cjaycalhoun/retro-clock-assistant/esphome/respeaker-voice-assistant.NOT_INCLUDED.md

# ReSpeaker Voice Assistant YAML Not Included

The full ReSpeaker ESPHome YAML is intentionally not included in this initial scaffold because it may contain device-specific settings or sensitive configuration.
