cjaycalhoun/retro-clock-assistant/stl/hisonic-led-socket.stl

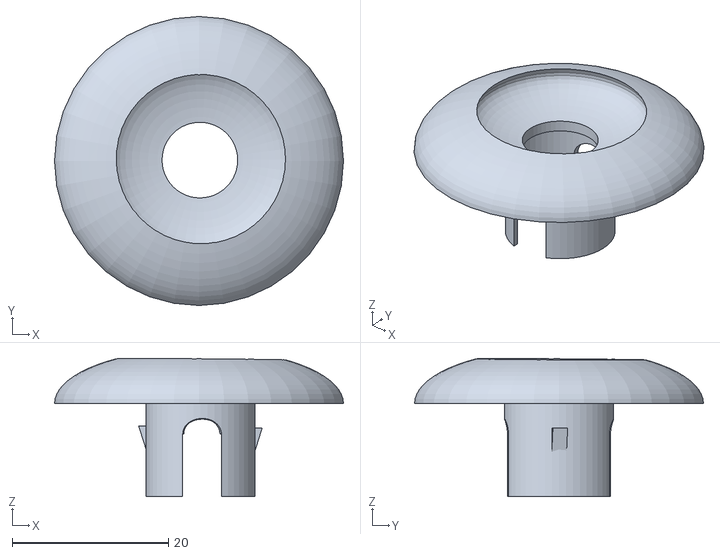
[picture p1: CAD file, 2026-10-13]
stl/hisonic-led-socket.stl
37.0 x 37.0 x 17.7
