cjaycalhoun/retro-clock-assistant/stl/hisonic-motor-ticker.stl

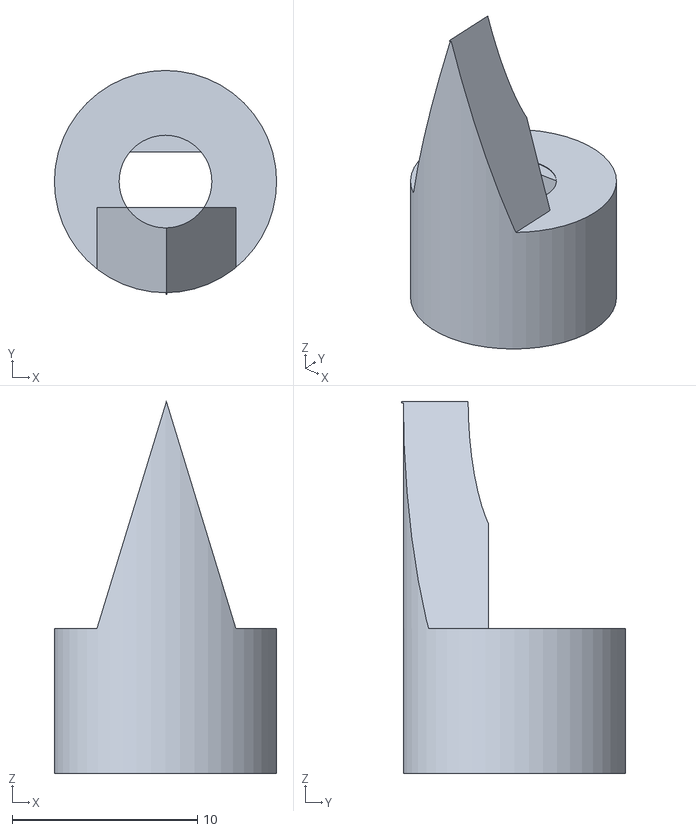
[picture p2: CAD file, 2026-10-13]
stl/hisonic-motor-ticker.stl
12.0 x 12.1 x 20.1
