cjaycalhoun/retro-clock-assistant/stl/hisonic-inner-brace.stl

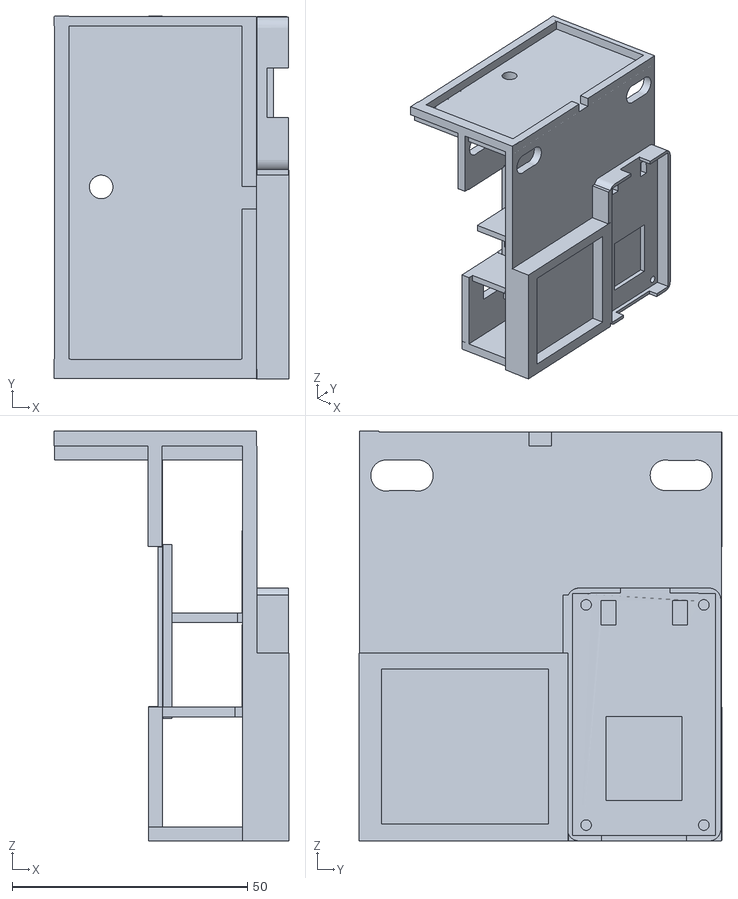
[picture p3: CAD file, 2026-10-13]
stl/hisonic-inner-brace.stl
49.9 x 77.2 x 87.2
