cjaycalhoun/retro-clock-assistant/assets/diagrams/hisonic-wiring-diagram-v2.png

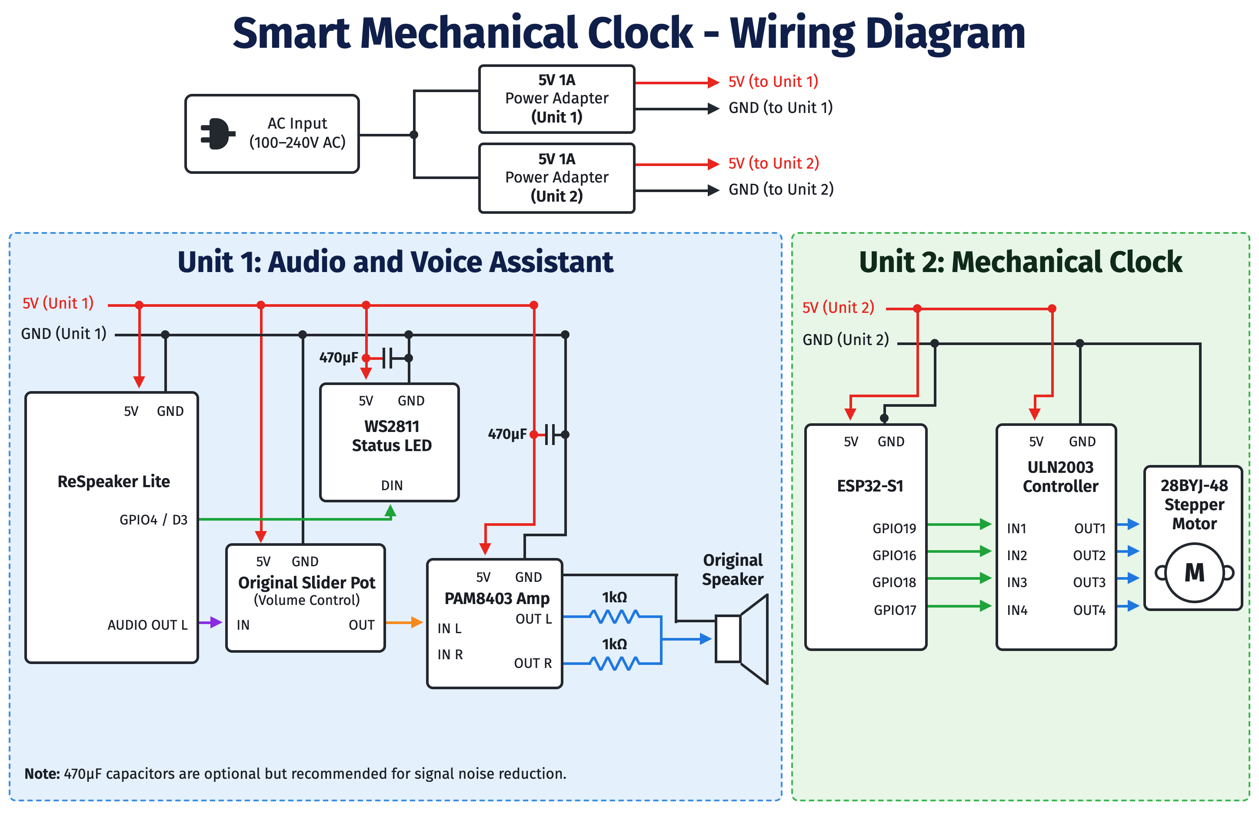
assets/diagrams/hisonic-wiring-diagram-v2.png
