cjaycalhoun/retro-clock-assistant/CHANGELOG.md

# Changelog

## Unreleased

- Imported the HiSonic package into the existing retro-clock-assistant repository.
- Added setup guidance and documented incomplete sync behavior.
- Initial project scaffold.
- Added current ESPHome motor baseline.
- Added documentation for hardware, wiring, calibration, voice sync design, and troubleshooting.
