cjaycalhoun/retro-clock-assistant/(commit log)

2026-10-09 Import HiSonic smart clock project scaffold
    [hisonic-clock-motor.yaml]
2026-10-09 Revise README for clarity and current project status
    Updated README to reflect current status and hardware details.
2026-10-13 Update section title for calibration procedure
2026-10-13 Update wiring.md to streamline speaker connection notes
    Removed redundant warning about speaker negatives and kept the important note.
2026-10-13 Fabrication files added
    [hisonic-inner-brace.stl, hisonic-led-socket.stl, hisonic-motor-ticker.stl]
2026-10-16 Add wiring diagram image to README
    Added wiring diagram image to README.
2026-10-16 Replace wiring diagram with updated version
    Updated wiring diagram image in README.
